spieswl/cotton-kandy-kart/elec/controller_schematic.pdf

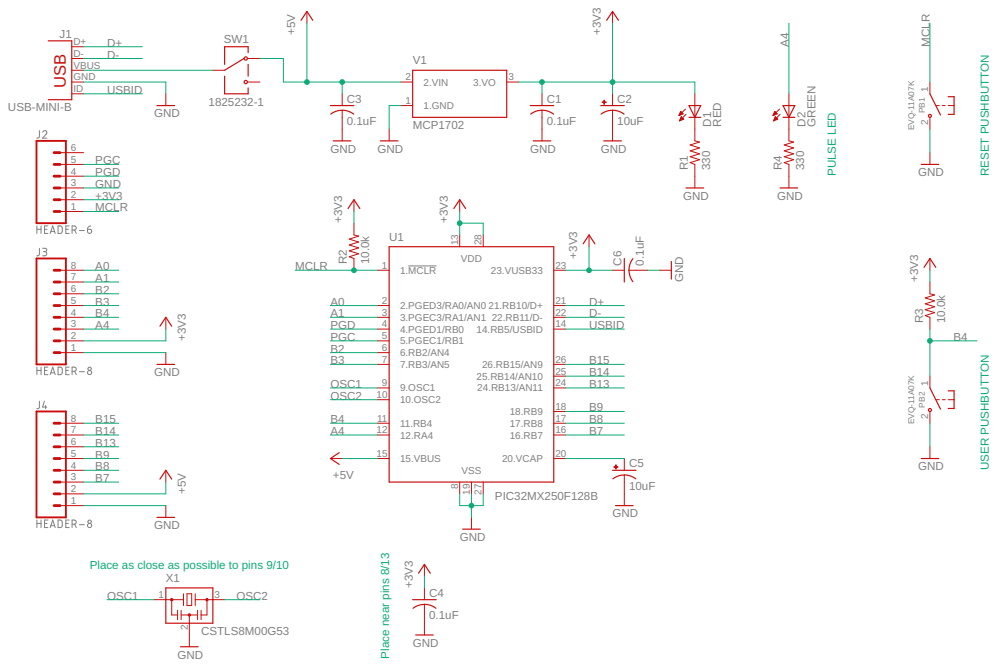
[picture p1: page 1]
