spieswl/cotton-kandy-kart/mech/CCK-BP01-01_DD.pdf

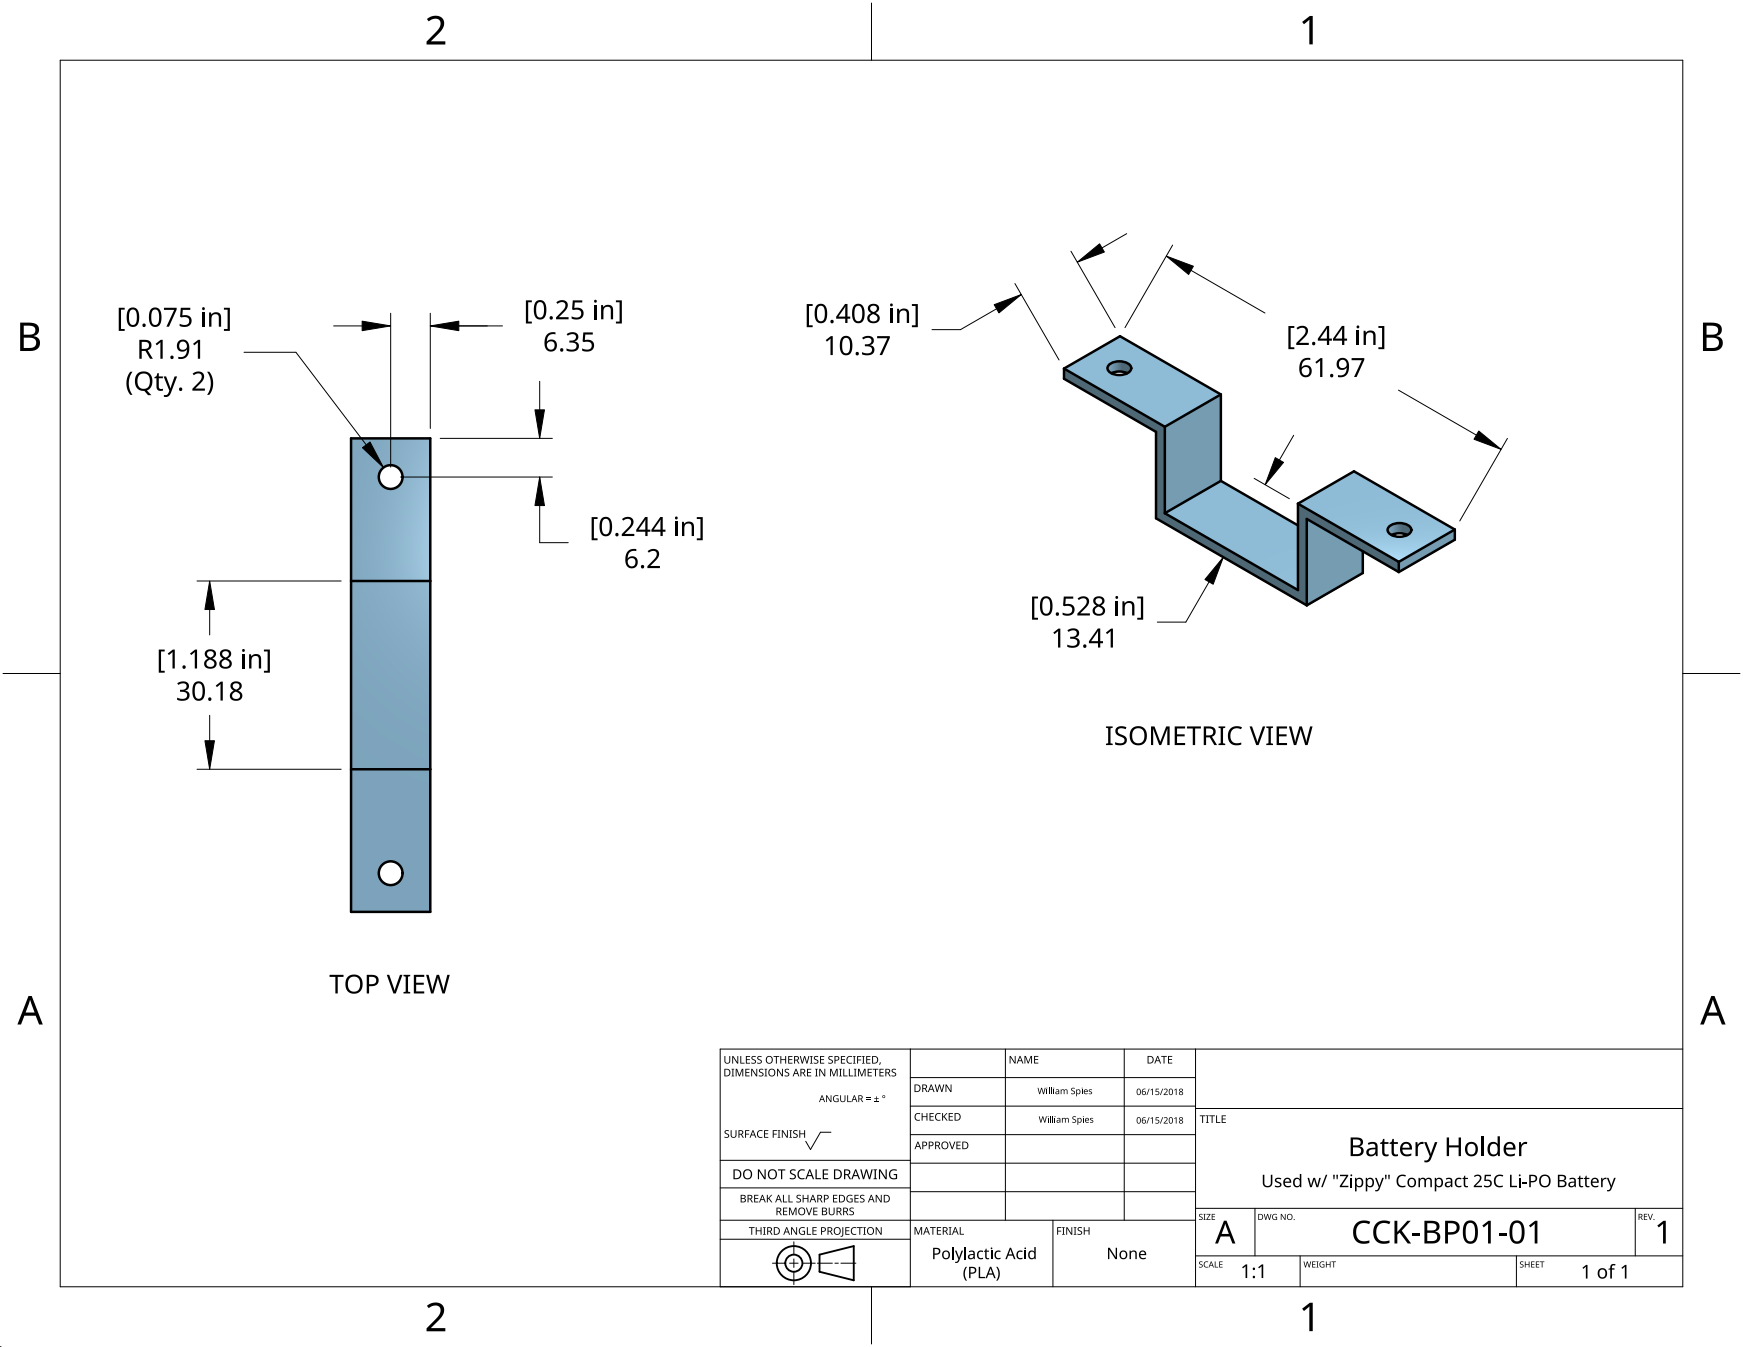
[picture p2: page 1]
