spieswl/cotton-kandy-kart/mech/CCK-CHAS01-01_DD.pdf

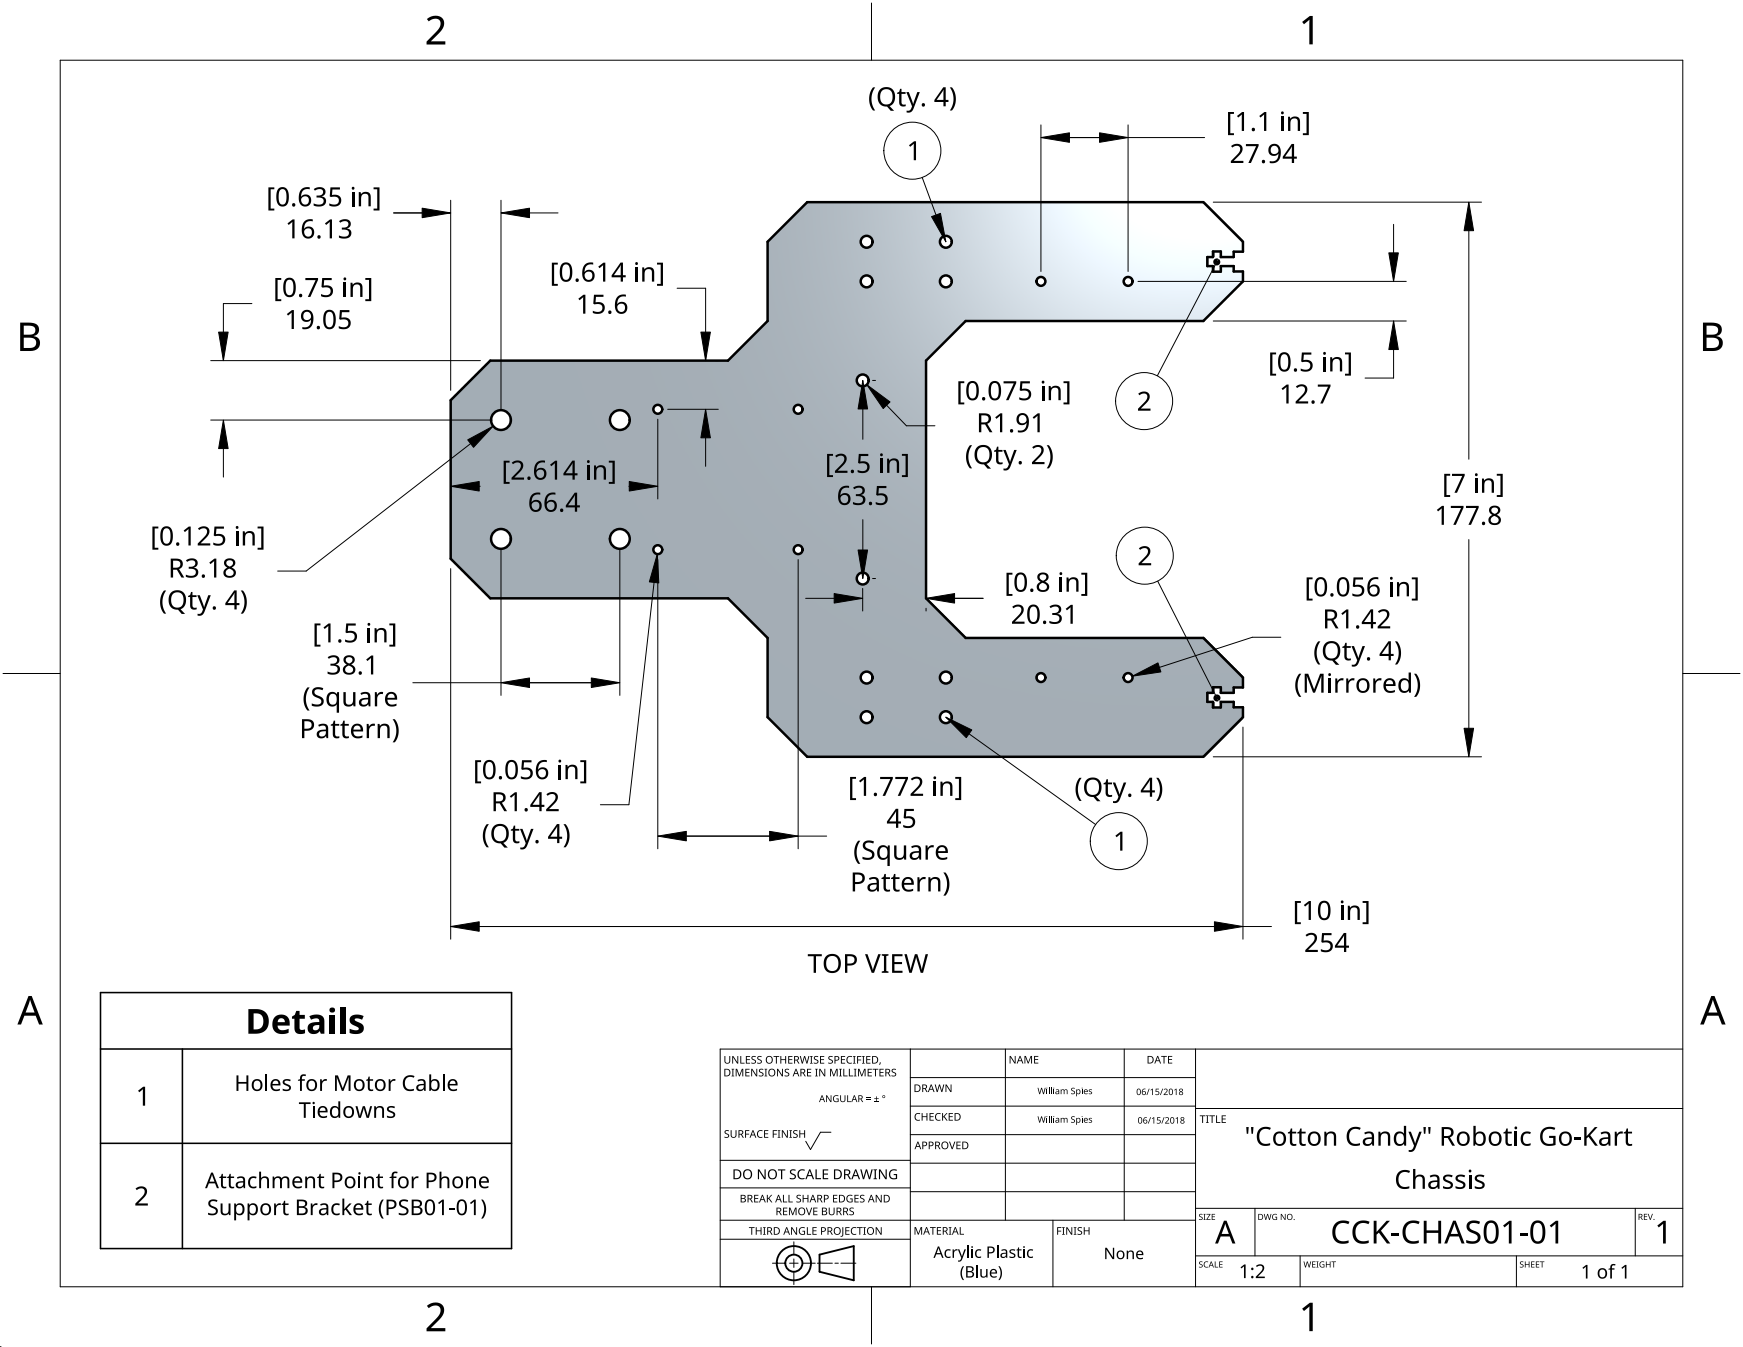
[picture p3: page 1]
