spieswl/cotton-kandy-kart/mech/CCK-PSB01-01_DD.pdf

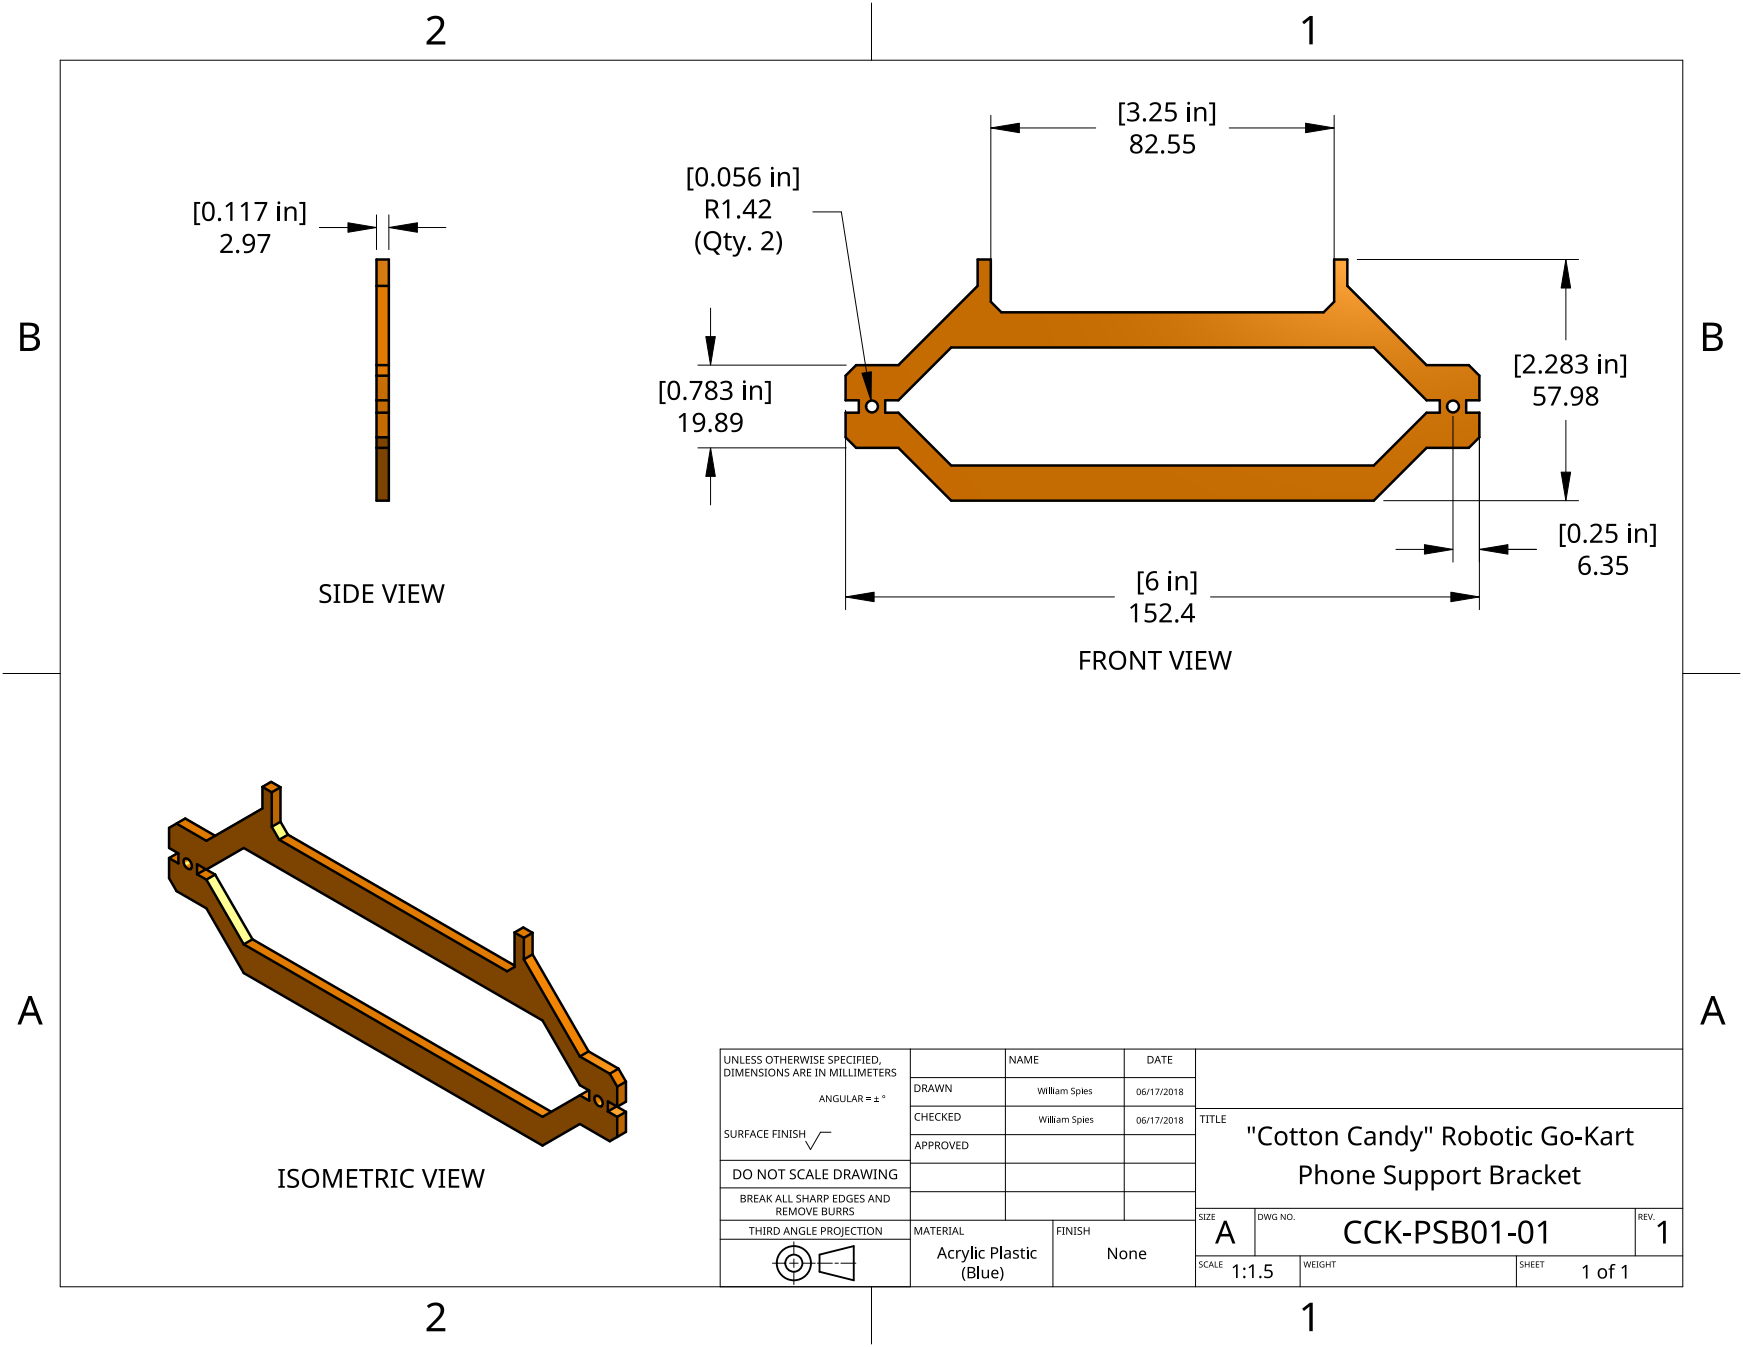
[picture p4: page 1]
