spieswl/cotton-kandy-kart/mech/CCK-PSB01-02_DD.pdf

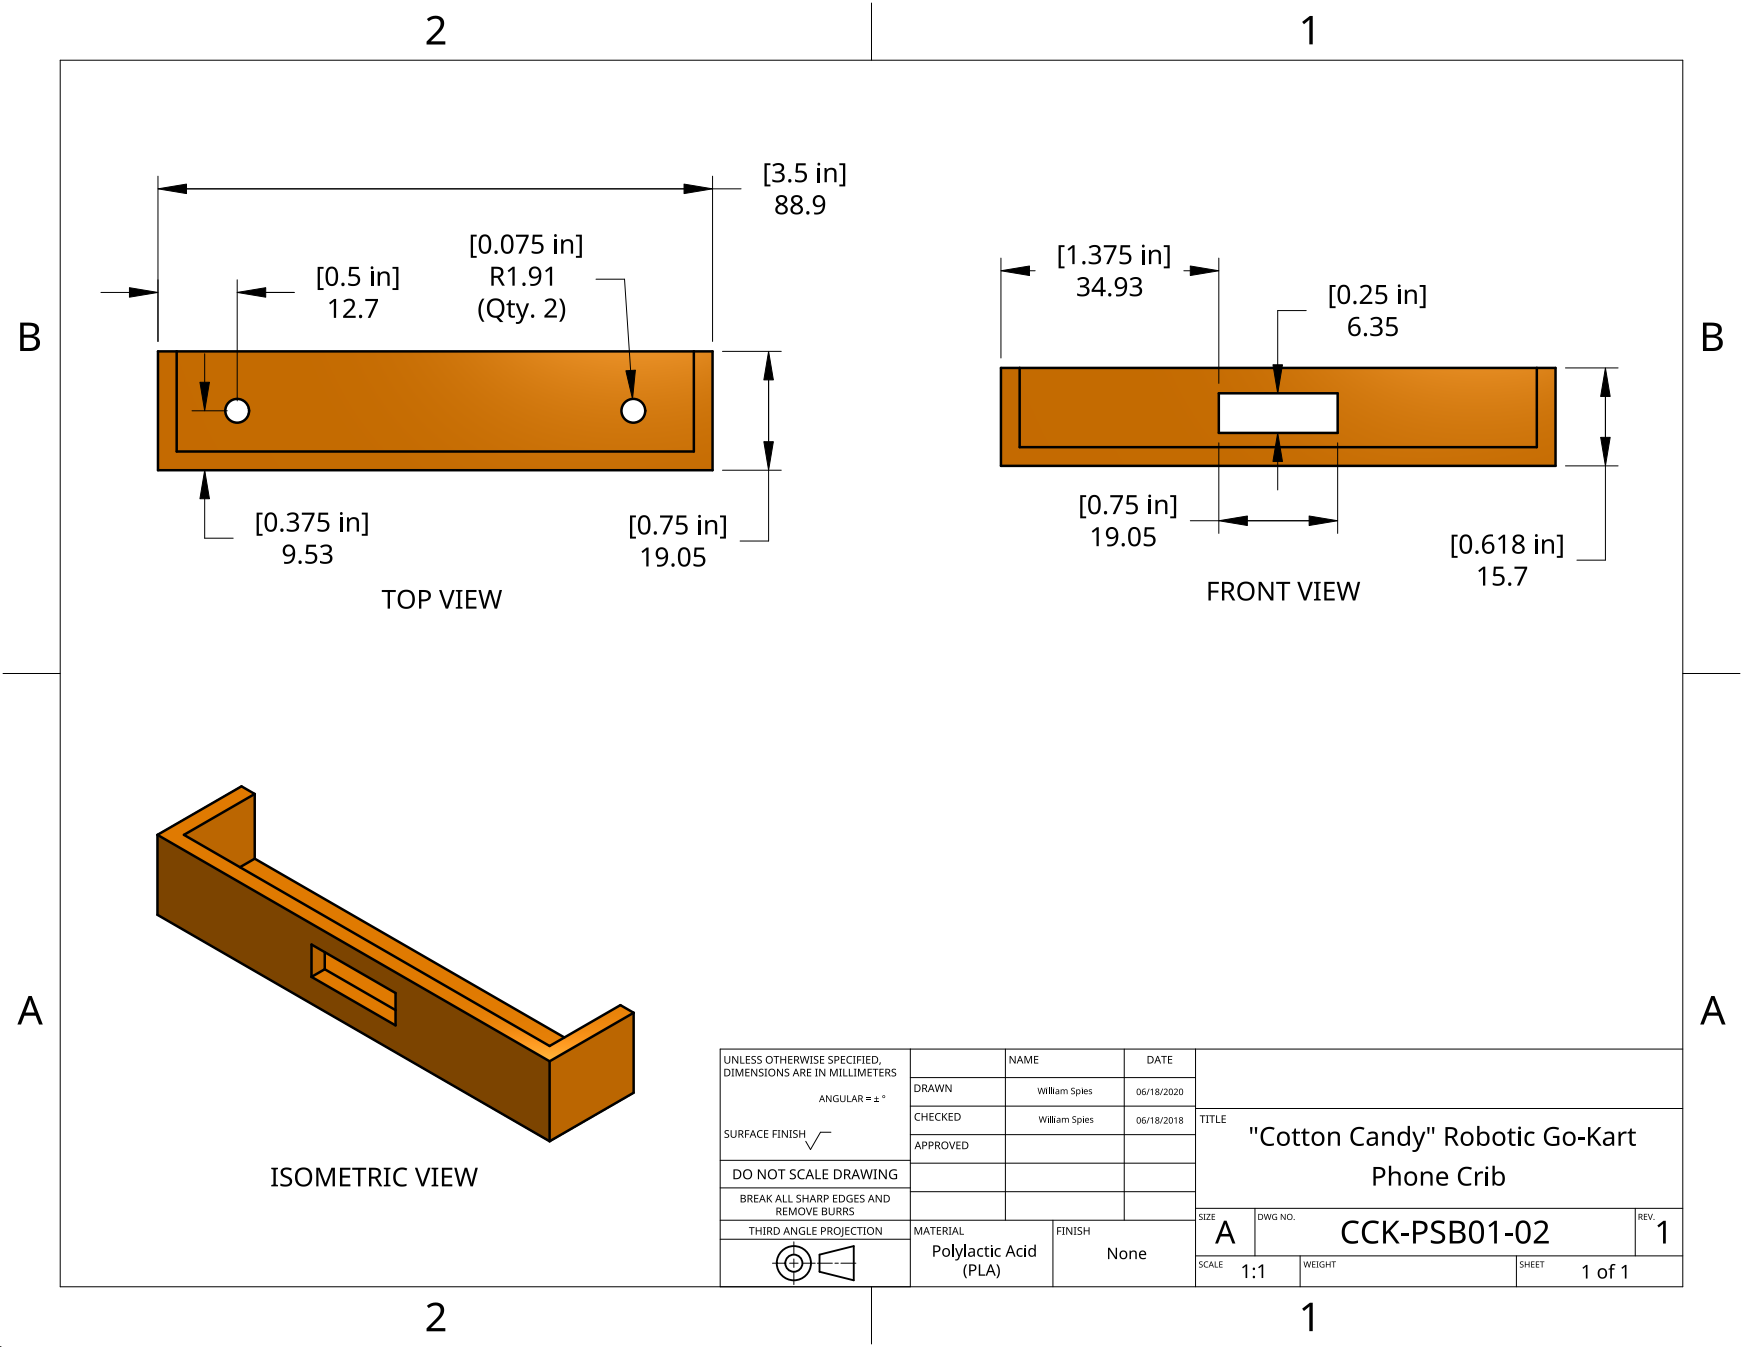
[picture p5: page 1]
