spieswl/cotton-kandy-kart/mech/CCK-TD01-01_DD.pdf

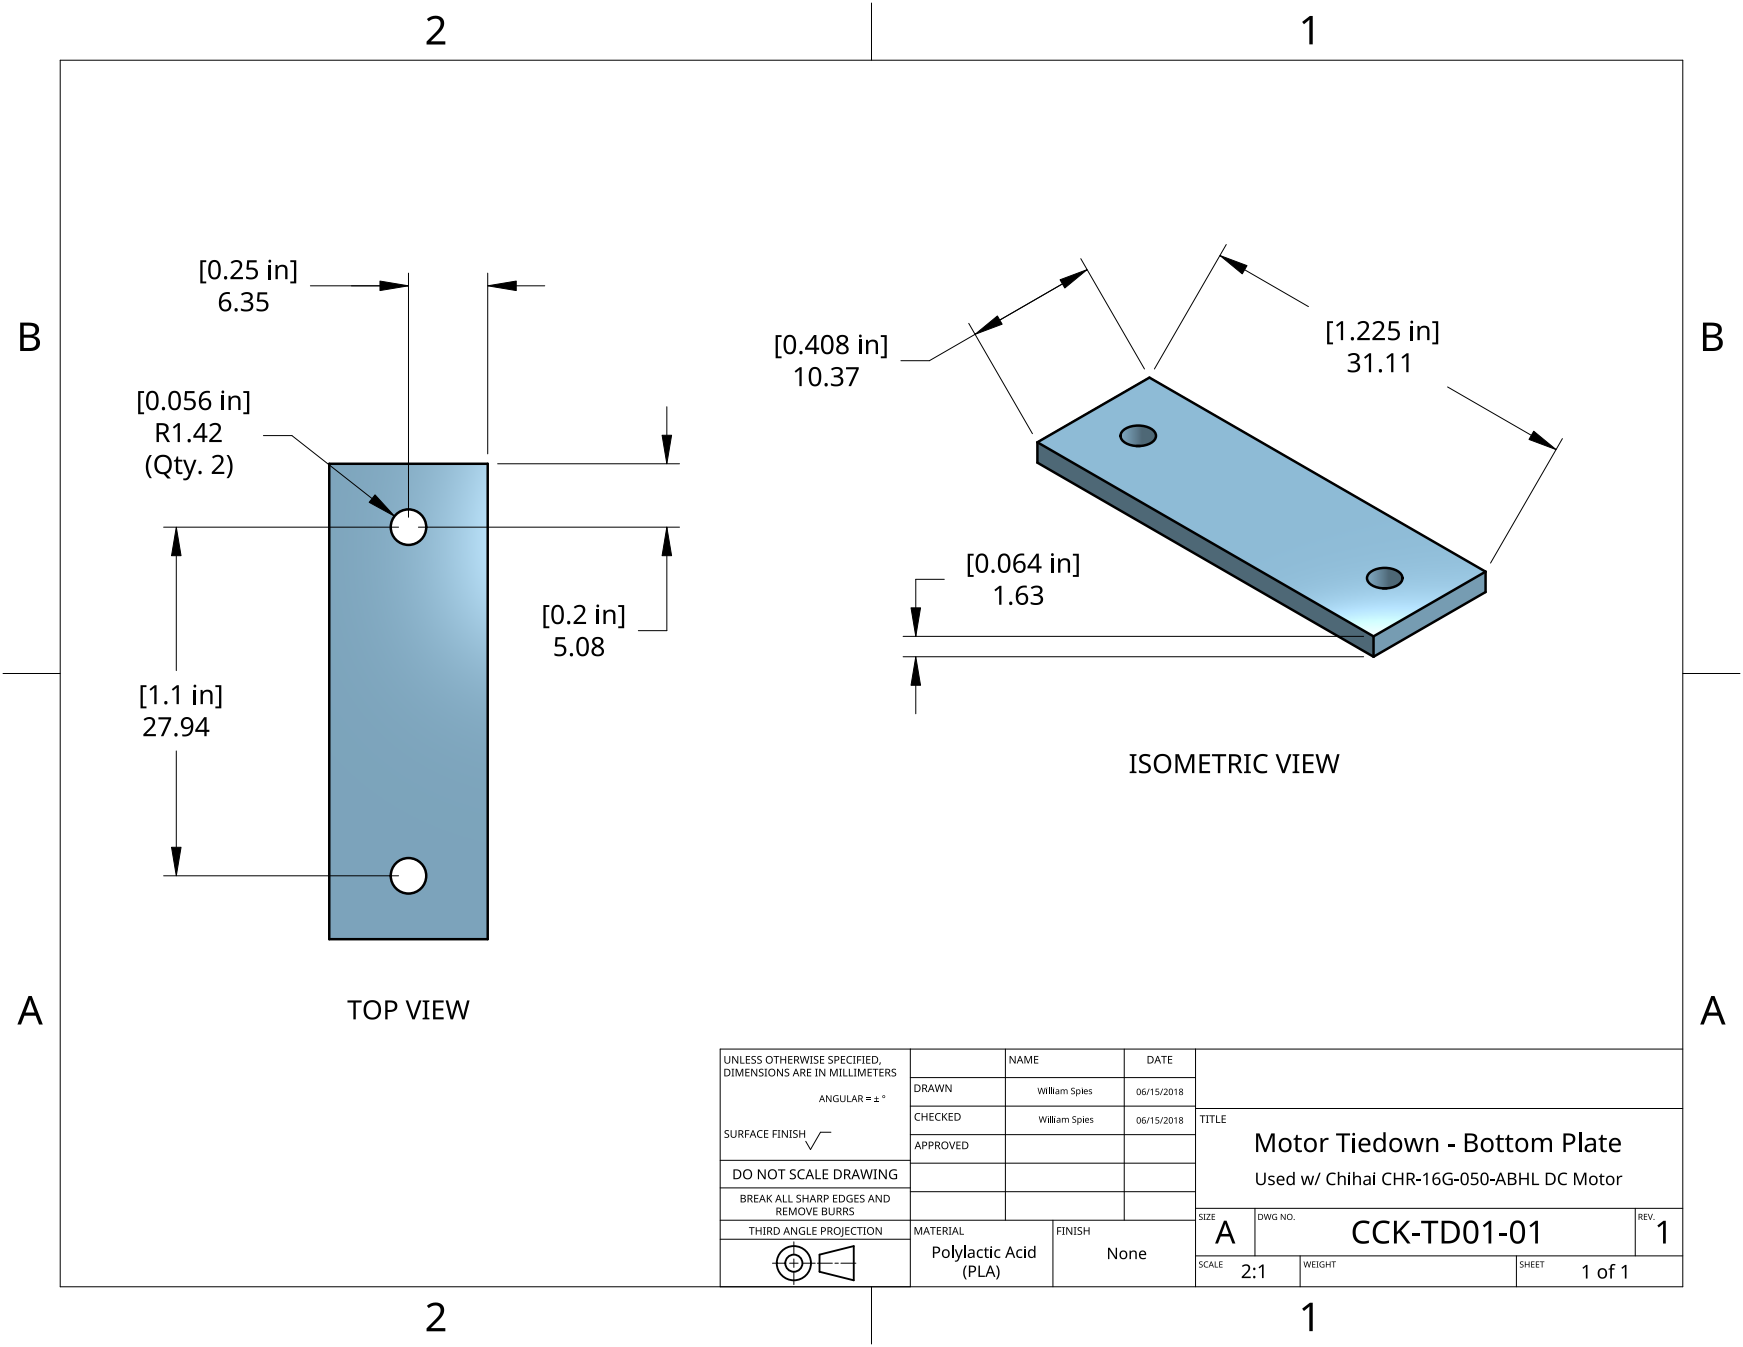
[picture p6: page 1]
