spieswl/cotton-kandy-kart/mech/CCK-TD01-02_DD.pdf

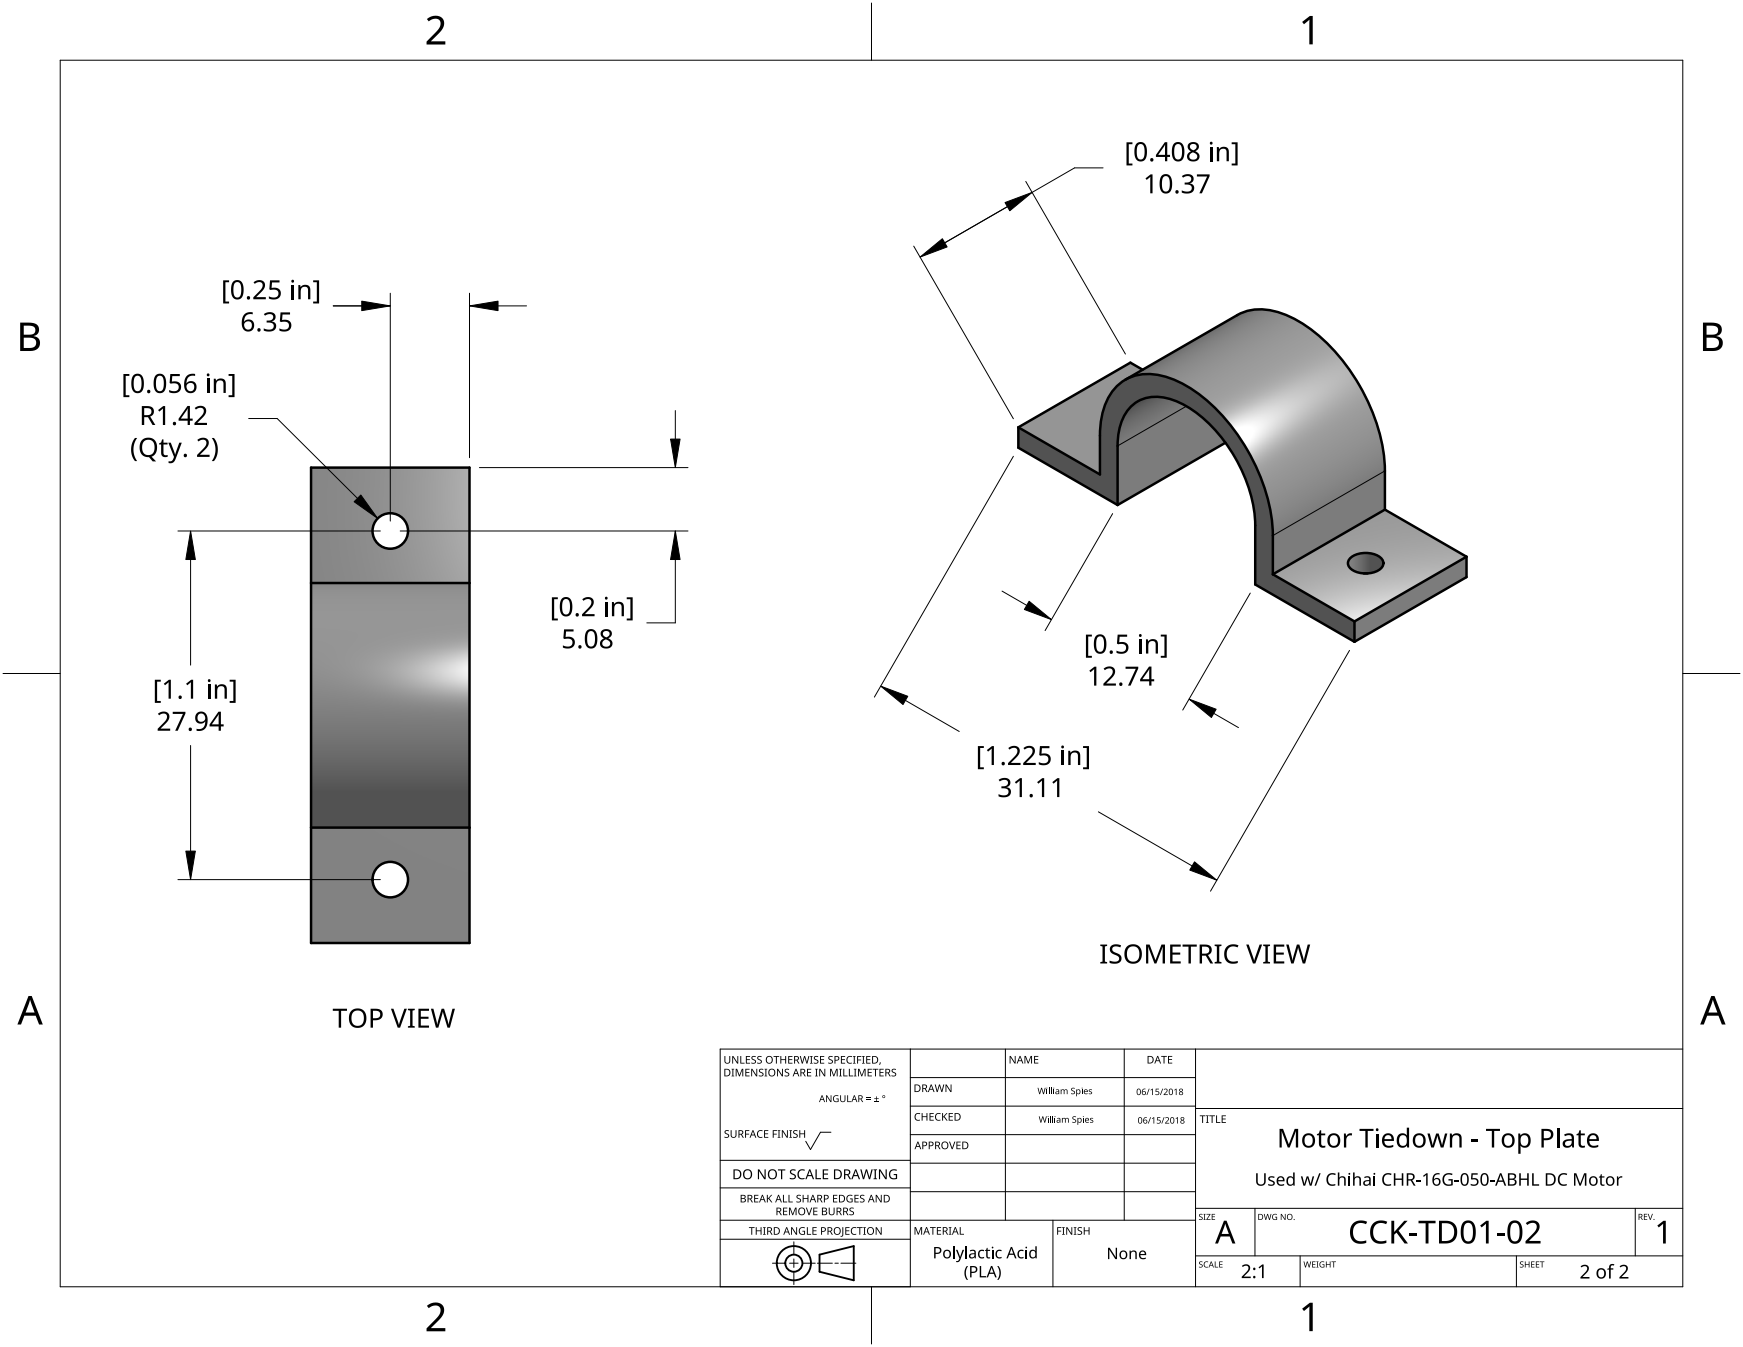
[picture p7: page 1]
