spieswl/cotton-kandy-kart/mech/CCK-WH01-01_DD.pdf

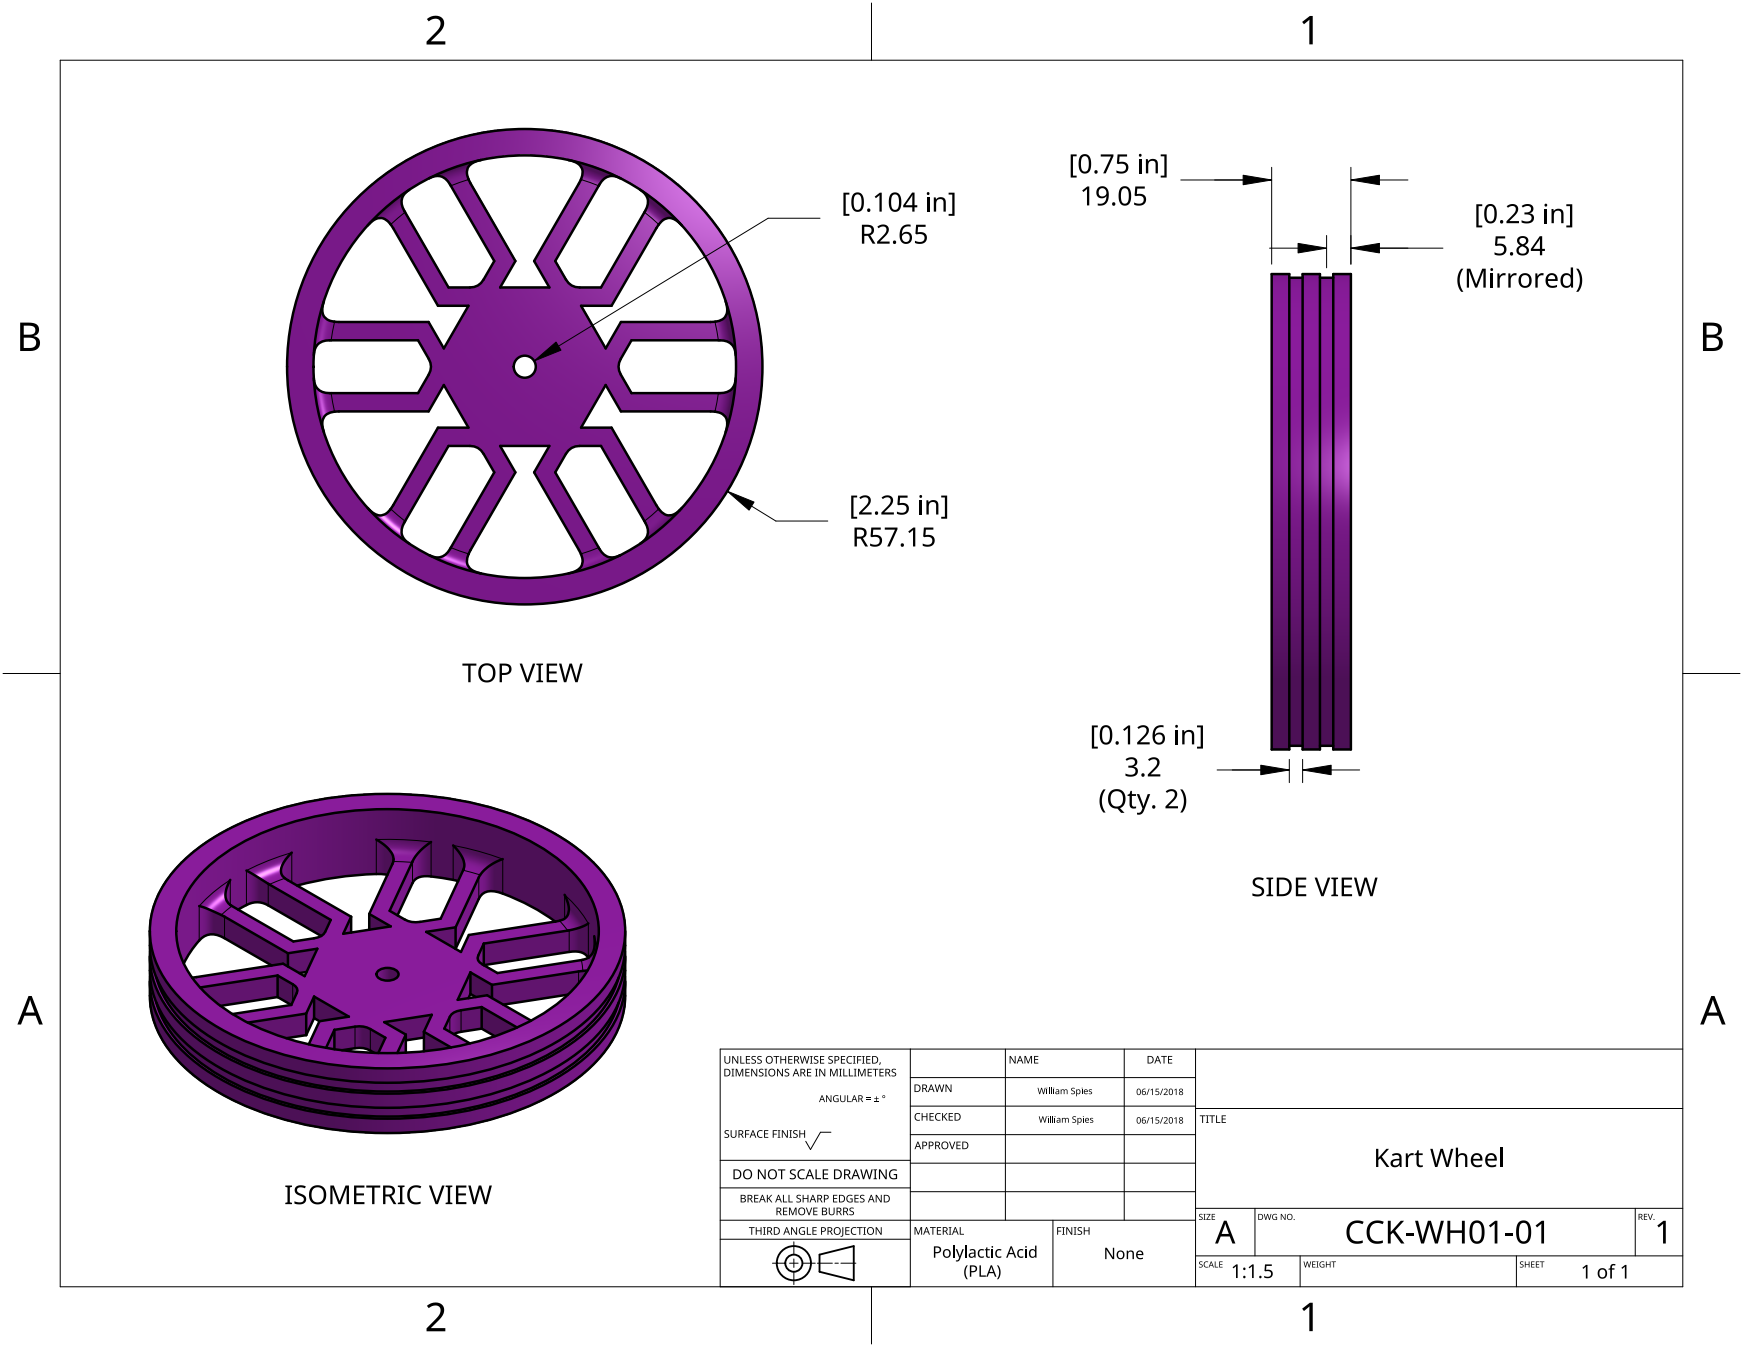
[picture p8: page 1]
