spieswl/cotton-kandy-kart/elec/controller_layout.pdf

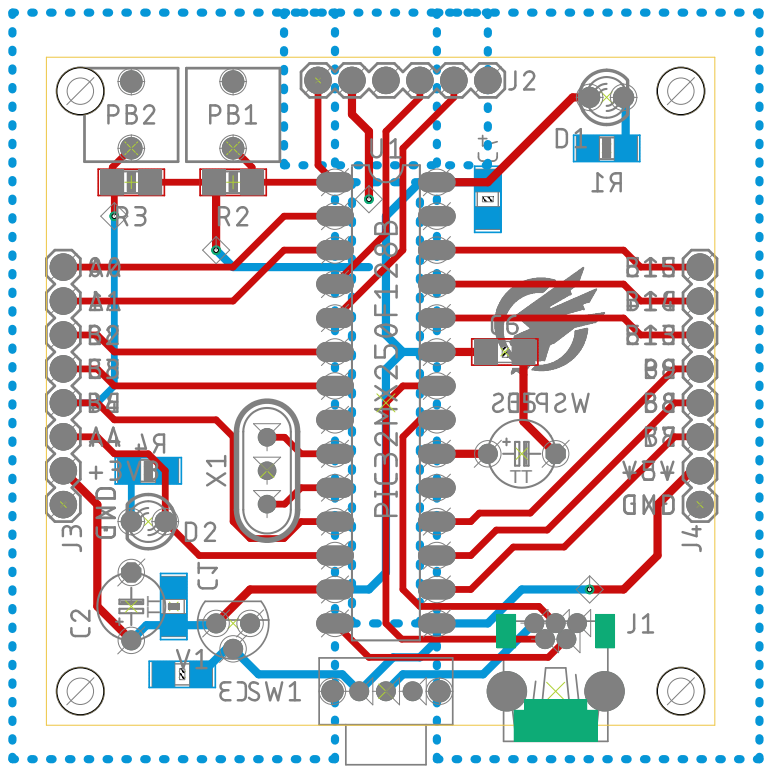
[picture p9: page 1]
