spieswl/cotton-kandy-kart/elec/eagle/kart_controller/ctrlr_rev2.brd

## EAGLE design elec/eagle/kart_controller/ctrlr_rev2.brd (2018-06-14)

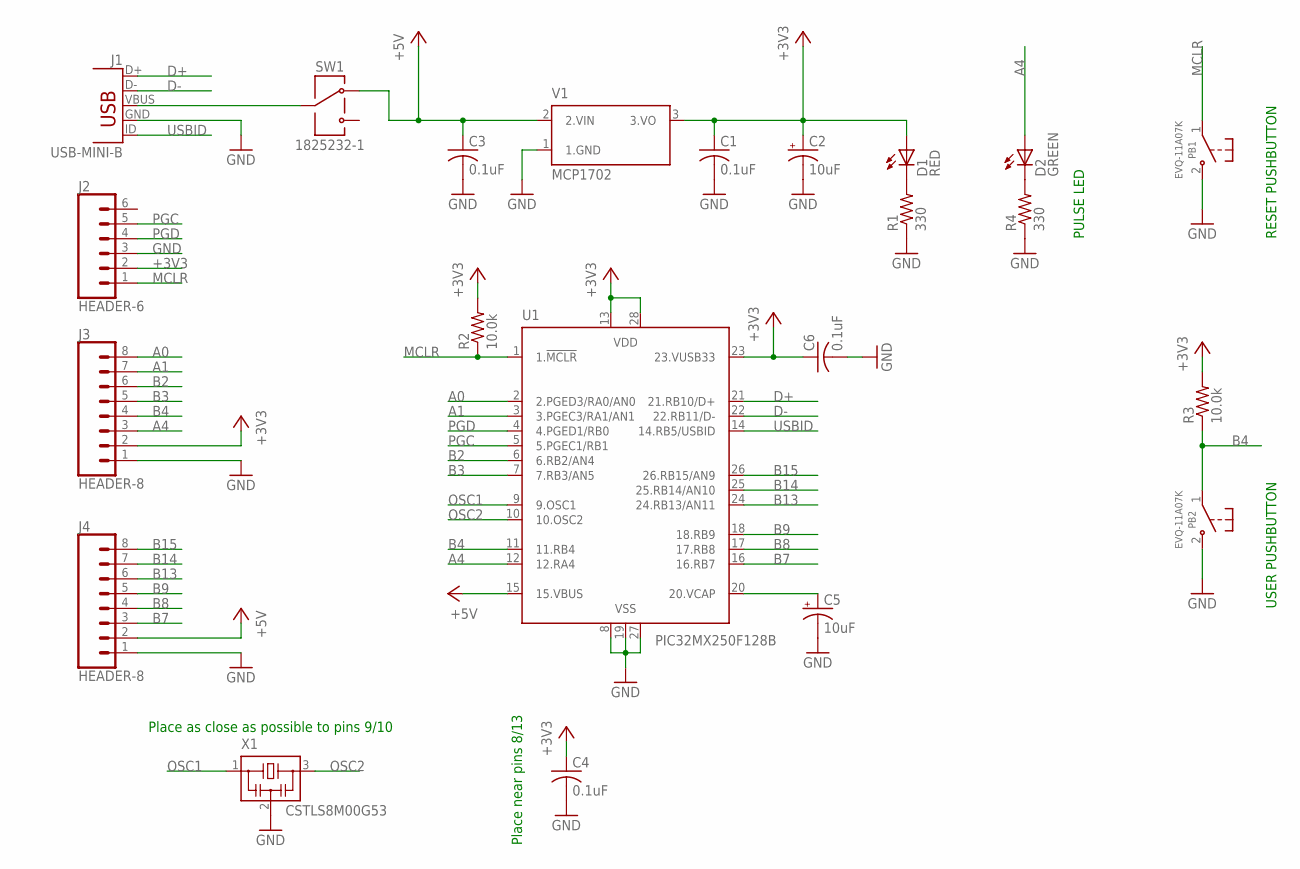
[picture p10: schematic ctrlr.sch]

Parts:
C1, C3, C4, C6: 0.1uF; C1206
C2, C5: 10uF; TAP5-50
D1: LED-RED; LED-3MM-V
D2: LED-GREEN; LED-3MM-V
J1: USB-MINI-B; USB-MB-TO
J2: HEADER-6; CONN_1X06
J3, J4: HEADER-8; CONN_1X08
PB1, PB2: EVQ-11A07K; PCPIN-2
R1, R4: 330; R1206
R2, R3: 10.0k; R1206
SW1: 1825232-1; PCPIN-3SS
U1: PIC32MX250F128B; DIP28-3
V1: MCP1702; TO-92
X1: CSTLS8M00G53; RAD-3-2.5

Connections:
+3V3: C1.1, C2.+, C4.1, C6.1, D1.A, J2.2 (2.), J3.2 (2.), R2.2, R3.2, U1.13 (13.VDD), U1.23 (23.VUSB33), U1.28 (28.AVDD), V1.3 (3.VO)
+5V: C3.1, J4.2 (2.), SW1.1, U1.15 (15.VBUS), V1.2 (2.VIN)
A0: J3.8 (8.), U1.2 (2.PGED3/RA0/AN0)
A1: J3.7 (7.), U1.3 (3.PGEC3/RA1/AN1)
A4: D2.A, J3.3 (3.), U1.12 (12.RA4)
B2: J3.6 (6.), U1.6 (6.RB2/AN4)
B3: J3.5 (5.), U1.7 (7.RB3/AN5)
B4: J3.4 (4.), PB2.1 (1.A), R3.1, U1.11 (11.RB4)
B7: J4.3 (3.), U1.16 (16.RB7)
B8: J4.4 (4.), U1.17 (17.RB8)
B9: J4.5 (5.), U1.18 (18.RB9)
B13: J4.6 (6.), U1.24 (24.RB13/AN11)
B14: J4.7 (7.), U1.25 (25.RB14/AN10)
B15: J4.8 (8.), U1.26 (26.RB15/AN9)
D+: J1.D+, U1.21 (21.RB10/D+)
D-: J1.D-, U1.22 (22.RB11/D-)
GND: C1.2, C2.-, C3.2, C4.2, C5.-, C6.2, J1.GND, J2.3 (3.), J3.1 (1.), J4.1 (1.), PB1.2 (2.B), PB2.2 (2.B), R1.1, R4.1, U1.8 (8.VSS), U1.19 (19.VSS), U1.27 (27.AVSS), V1.1 (1.GND), X1.2
MCLR: J2.1 (1.), PB1.1 (1.A), R2.1, U1.1 (1.!MCLR)
unnamed: D2.K (C), R4.2
unnamed: D1.K (C), R1.2
unnamed: J1.VBUS, SW1.2
unnamed: C5.+, U1.20 (20.VCAP)
OSC1: U1.9 (9.OSC1), X1.1
OSC2: U1.10 (10.OSC2), X1.3
PGC: J2.5 (5.), U1.5 (5.PGEC1/RB1)
PGD: J2.4 (4.), U1.4 (4.PGED1/RB0)
USBID: J1.ID, U1.14 (14.RB5/USBID)

Notes on the sheet:
Place near pins 8/13
USER PUSHBUTTON
RESET PUSHBUTTON
Place as close as possible to pins 9/10
PULSE LED

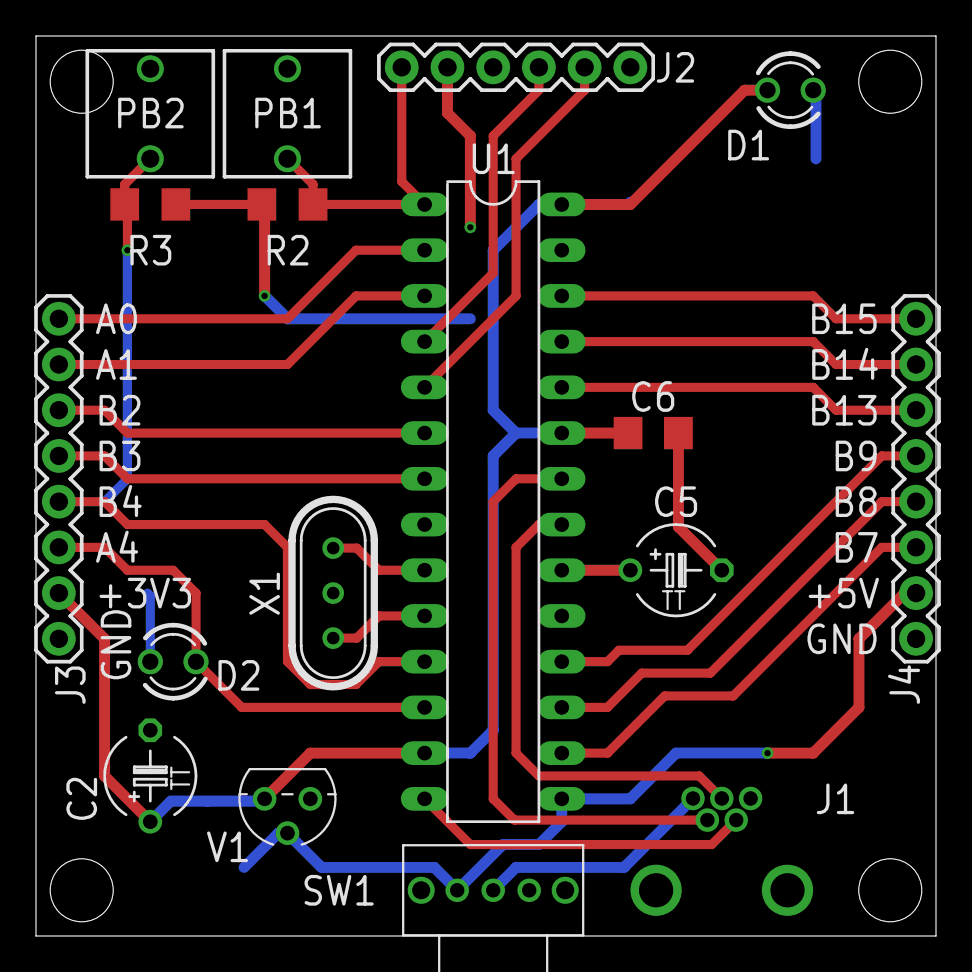
[picture p11: board ctrlr_rev2.brd from above]

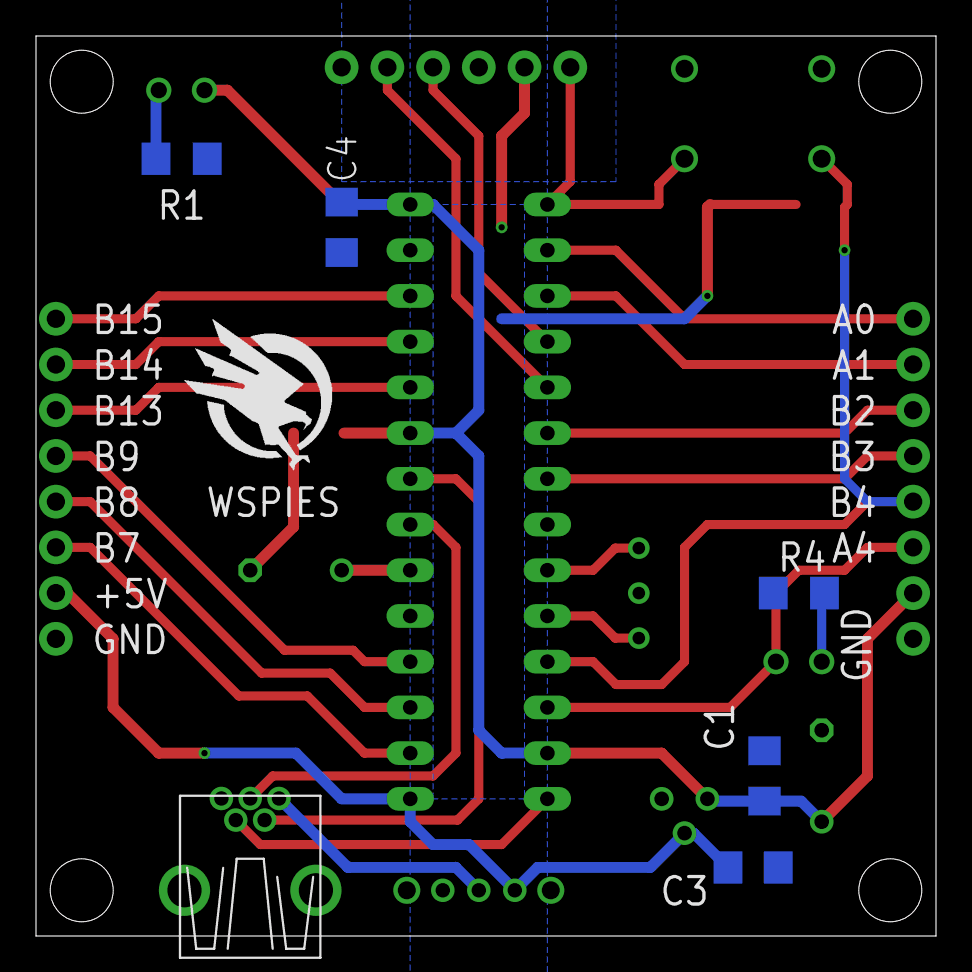
[picture p12: board ctrlr_rev2.brd from below]

Board: 2 copper layers, 50.0 x 50.0 mm, 22 parts (5 on the bottom side), 27 nets.
