spieswl/cotton-kandy-kart/(commit log)

2018-04-09 Added MPLAB IDE project and introduced template code. Also some initial screencaps of power supply circuit ripple (and suppression).
2018-04-09 Code compiles and loads to PIC32 microcontroller; LED 2 is working.
    Now to add the looping code.
2018-04-12 Schematic and board layout complete, may need further refinement for header locations.
    [ctrlr.brd, ctrlr.sch]
2018-04-12 Moved the Eagle project to its own folder; Nick doesn't have HW3 stuff up yet so looks like this will be in its own area for the moment.
    [ctrlr.brd, ctrlr.sch]
2018-04-13 Added Gerbers for HW3, tweaked board layout and saved as Rev2. Not happy on the hole sizing on the layout (thanks Eagle) so I may come back and make those larger for standard standoffs.
    [ctrlr.sch, ctrlr_rev1.brd, ctrlr_rev2.brd]
2018-04-13 Changed the mounting hole size to be 3.5mm diameter, to handle standard post holes from something like a #4 standoff.
2018-04-18 HW4 started, have SPI communication to the MCP4912 working, verified by using SPI interface to command MCP4912 to output 1.65 V on DAC Channel A and 3.0 V on DAC Channel B.
2018-04-18 Refactored a bunch of stuff, HW4 is now complete, renamed directories to be a little clearer when looking through the files.
    [ctrlr.sch, ctrlr_rev1.brd, ctrlr_rev2.brd, ctrlr_w_MCP4912.sch]
2018-04-24 HW5 complete, added I2C code and schematics for I2C circuit in HW5 folder.
    [ctrlr_w_MCP23008.sch]
2018-04-25 HW6 in progress, LCD_drawChar code works on the LCD display, which is wired up and operational.
2018-04-25 HW6 complete, updated assignment to draw FPS graph and progress bar. Plus added a schematic showing the connections in the included Eagle project.
    [ctrlr_w_ST7735.sch]
2018-04-30 HW7 Checkpoint : IMU interface is working correctly, X-Axis bars are working correctly (could use some polishing however). Need to extend IMU measurement scale to Y-Axis.
    [main.c]
2018-05-01 HW7 checkpoint : Both Y-axis and X-axis bars are working properly, fixed some bugs, added a little bit more logging to the main program.
    [main.c]
2018-05-07 Initial pass at CDC programming, sample code is set up and working properly. Moving onto the bulk of HW9 coding.
2018-05-07 Adding IMU code to HW9, not happy with the polling frequency of the IMU (essentially just unsure of whether or not I should have the IMU read in a different area than message write, seems like I shou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
2018-05-08 Tweaked HW9 code (after conferring w/ the Wiznitzers on state machine machinations). Should be at 100 Hz for everything now.
2018-05-10 Added filter functions to a DSP header, need to add weights to FIR filter and add main-line code to leverage those filtering capabilities to tasks.
2018-05-10 HW10 is complete and tested, fixed some bugs with each of the filters, performance seems really good! Also synthesized the HW11 project for HID mouse control.
    [app.c, app.h, main.c]
2018-05-10 HW11 complete; mouse works, tested it just a little bit ago. Needed to remove the (-1) being multiplied by the values for it to not have "inverted X, inverted Y" functionality. Also used X and Z acce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
    I could absolutely tweak with the signed short values to reduce how quickly my mouse moves around on Ubuntu linux, but I'll just leave it as is for now.
    [app.c, app.h]
2018-05-10 Added the 9 "zeroes" and 1 true accelerometer value code, so its not blasting the IMU values every time the code sends an HID report.
2018-05-20 Completed HW13 project with the Camera app.
2018-05-23 PIC code now working correctly for HW14, added Android Studio project for the second part of the exercise.
    [MainActivity.java, app.c, app.h, main.c]
2018-05-28 Added pictures of my living hinge box and the 3D-printed wheel designs.
2018-06-12 Fixed some bugs in the Android app, tested it and it works with the PIC.
    [MainActivity.java, app.c, app.h]
2018-06-14 Moved in my electrical schematics and added some pictures showing the final design.
    [ctrlr.sch, ctrlr_rev2.brd]
2018-06-18 Reconfigured old ME433 repository into a dedicated repo (while preserving the commit history) for the aptly-named Cotton Kandy robotic kart.
    [ctrlr.sch, ctrlr_rev1.brd, ctrlr_rev2.brd, ctrlr_w_MCP23008.sch, ctrlr_w_MCP4912.sch, ctrlr_w_ST7735.sch]
2018-07-07 Added PDFs of both the schematic and the PCB layout, for preview purposes.
